FRC1756-Argos/Argos-Battery-Charge-Monitor/README.md

# Argos-Battery-Charge-Monitor
System to monitor a set of charging batteries
