FRC1756-Argos/Argos-Battery-Charge-Monitor/PCB/BOM.xlsx

Sheet: Sensor
Label | Description | Part | Quantity | Unit Price | Total Price | URL
U1 | 20A Current Sensor | ACS712ELCTR-20A-T | 1 | 3.94 | 3.94 | https://www.digikey.com/product-detail/en/allegro-microsystems-llc/ACS712ELCTR-20A-T/620-1190-1-ND/1284607
U2 | 5V Linear Regulator | L78M05CDT-TR | 1 | 0.367 | 0.367 | https://www.digikey.com/product-detail/en/stmicroelectronics/L78M05CDT-TR/497-1203-1-ND/586203
U3 | ATTiny 84 | ATTINY84A-SSU | 1 | 0.82 | 0.82 | https://www.digikey.com/product-detail/en/microchip-technology/ATTINY84A-SSU/ATTINY84A-SSU-ND/3046522
U4 | I2C Differential Driver | PCA9615DPJ | 1 | 2.62 | 2.62 | https://www.digikey.com/product-detail/en/nxp-usa-inc/PCA9615DPJ/568-11484-1-ND/4864508
 | RJ-25 Port | E5566-Q0LK22-L | 2 | 0.3512 | 0.7024 | https://www.digikey.com/product-detail/en/pulse-electronics-network/E5566-Q0LK22-L/553-2258-ND/1785239
 | DIP Switches | 210-4MS | 1 | 0.543 | 0.543 | https://www.digikey.com/product-detail/en/cts-electrocomponents/210-4MS/CT2104MS-ND/2503781
R1 | 30K Resistor (Voltage Divider) | RMCF0805JT30K0 | 1 | 0.017 | 0.017 | https://www.digikey.com/product-detail/en/stackpole-electronics-inc/RMCF0805JT30K0/RMCF0805JT30K0CT-ND/1942584
R2 | 10K Resistor (Voltage Divider) | RMCF0805JT10K0 | 1 | 0.017 | 0.017 | https://www.digikey.com/product-detail/en/stackpole-electronics-inc/RMCF0805JT10K0/RMCF0805JT10K0CT-ND/1942577
R3 | 4.7K Resisor (I2C Pull Up) | RMCF0805JT4K70 | 2 | 0.017 | 0.034 | https://www.digikey.com/product-detail/en/stackpole-electronics-inc/RMCF0805JT4K70/RMCF0805JT4K70CT-ND/1942570
R4 | 600 Resistor (Differential I2C Pull) | RC0805FR-07604RL | 4 | 0.022 | 0.088 | https://www.digikey.com/product-detail/en/yageo/RC0805FR-07604RL/311-604CRCT-ND/731022
R5 | 120 Resistor (Differential I2C Terminator) | RMCF0805JT120R | 2 | 0.017 | 0.034 | https://www.digikey.com/product-detail/en/stackpole-electronics-inc/RMCF0805JT120R/RMCF0805JT120RCT-ND/1942540
R6 | 160 Resistor (LED Limit) | RMCF0805JT160R | 1 | 0.017 | 0.017 | https://www.digikey.com/product-detail/en/stackpole-electronics-inc/RMCF0805JT160R/RMCF0805JT160RCT-ND/5049817
 | ISP Header | PPPC032LFBN-RC | 1 | 0.586 | 0.586 | https://www.digikey.com/product-detail/en/sullins-connector-solutions/PPPC032LFBN-RC/S7106-ND/810243
C1 | Decoupling Capacitor | CL21B104KBFNNNG | 3 | 0.02 | 0.06 | https://www.digikey.com/product-detail/en/samsung-electro-mechanics/CL21B104KBFNNNG/1276-6468-1-ND/5958096
 |  |  | One Board | 9.8454
 |  |  | Num Boards | 10
 |  |  | Total | 98.454

Sheet: HAT
Label | Description | Part | Quantity | Unit Price | Total Price | URL
U1 | I2C Differential Driver | PCA9615DPJ | 1 | 2.62 | 2.62 | https://www.digikey.com/product-detail/en/nxp-usa-inc/PCA9615DPJ/568-11484-1-ND/4864508
 | RJ-25 Port | E5566-Q0LK22-L | 1 | 0.3512 | 0.3512 | https://www.digikey.com/product-detail/en/pulse-electronics-network/E5566-Q0LK22-L/553-2258-ND/1785239
R1 | 600 Resistor (Differential I2C Pull) | RC0805FR-07604RL | 4 | 0.022 | 0.088 | https://www.digikey.com/product-detail/en/yageo/RC0805FR-07604RL/311-604CRCT-ND/731022
R2 | 120 Resistor (Differential I2C Terminator) | RMCF0805JT120R | 2 | 0.017 | 0.034 | https://www.digikey.com/product-detail/en/stackpole-electronics-inc/RMCF0805JT120R/RMCF0805JT120RCT-ND/1942540
 | 2x20 HAT Header | SSQ-120-03-T-D | 1 | 4.5 | 4.5 | https://www.digikey.com/product-detail/en/samtec-inc/SSQ-120-03-T-D/SAM1204-20-ND/1111840
U2 | RTC | DS3231MZ+ | 1 | 7.72 | 7.72 | https://www.digikey.com/product-detail/en/maxim-integrated/DS3231MZ/DS3231MZ-ND/2754396
 | Backup Battery Holder | BAT-HLD-012-THM | 1 | 0.28 | 0.28 | https://www.digikey.com/product-detail/en/linx-technologies-inc/BAT-HLD-012-THM/BAT-HLD-012-THM-ND/3044012
C1 | Decoupling Capacitor | CL21B104KBFNNNG | 3 | 0.02 | 0.06 | https://www.digikey.com/product-detail/en/samsung-electro-mechanics/CL21B104KBFNNNG/1276-6468-1-ND/5958096
 |  |  | One Board | 15.6532
 |  |  | Num Boards | 1
 |  |  | Total | 15.6532
