FRC1756-Argos/Argos-Battery-Charge-Monitor/PCB/HAT/Argos_Battery_Charge_Monitor_HAT.brd

## EAGLE design PCB/HAT/Argos_Battery_Charge_Monitor_HAT.brd (2017-11-20)

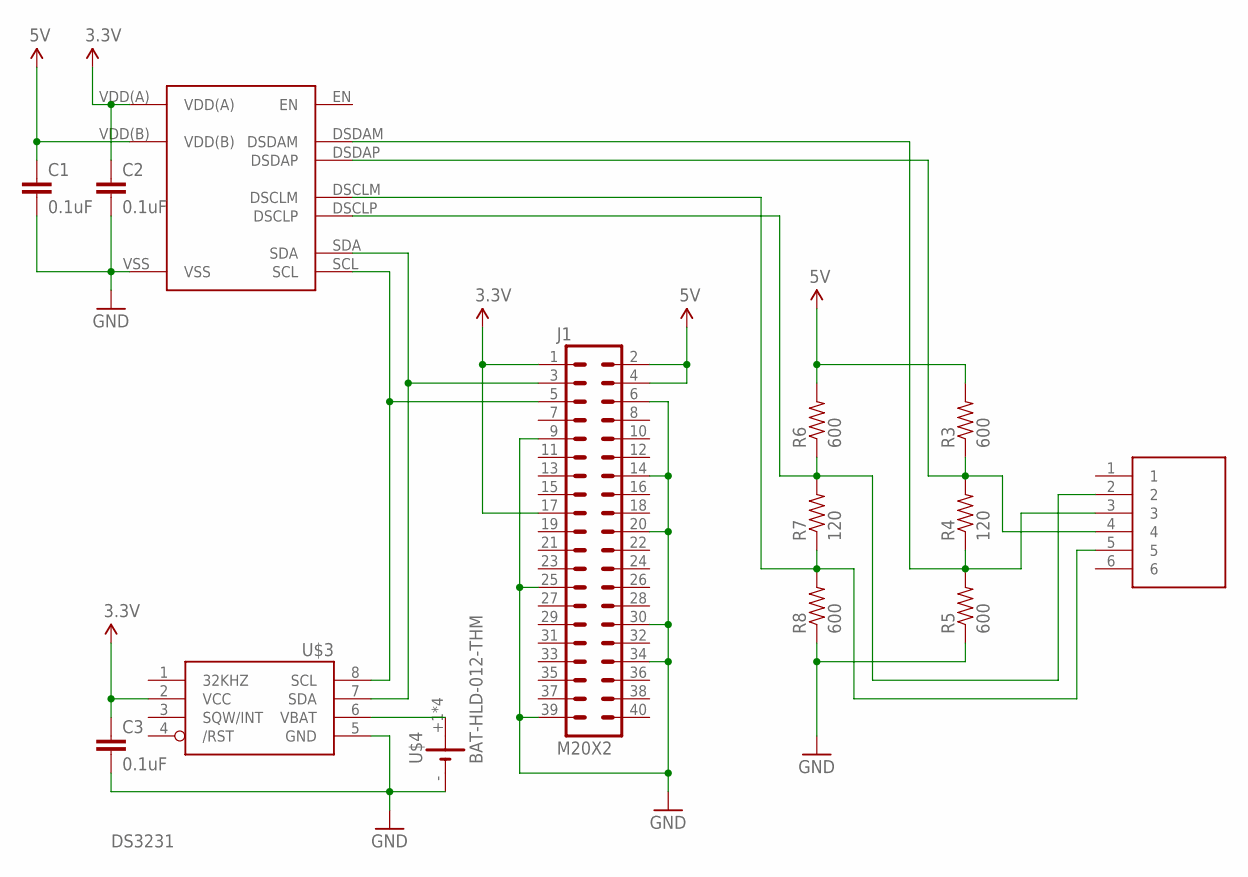
[picture p1: schematic Argos_Battery_Charge_Monitor_HAT.sch]

Parts:
C1, C2, C3: 0.1uF; 0805
J1: M20X2; 2X20
R3, R5, R6, R8: 600; 0805
R4, R7: 120; 0805
U$1: E5566-Q0LK22-L
U$2: SOP50P490X110-10N
U$3: DS3231MZ; SOIC8
U$4: BAT-HLD-012-THM

Connections:
3.3V: C2.1, C3.1, J1.1, J1.17, U$2.VDD(A), U$3.2 (VCC)
5V: C1.1, J1.2, J1.4, R3.2, R6.2, U$2.VDD(B)
D_SCL_M: R7.1, R8.2, U$1.5, U$2.DSCLM
D_SCL_P: R6.1, R7.2, U$1.2, U$2.DSCLP
D_SDA_M: R4.1, R5.2, U$1.3, U$2.DSDAM
D_SDA_P: R3.1, R4.2, U$1.4, U$2.DSDAP
GND: C1.2, C2.2, C3.2, J1.6, J1.9, J1.14, J1.20, J1.25, J1.30, J1.34, J1.39, R5.1, R8.1, U$2.VSS, U$3.5 (GND), U$4.-
unnamed: U$3.6 (VBAT), U$4.+1 (+), U$4.+2 (+), U$4.+3 (+), U$4.+4 (+)
SCL: J1.5, U$2.SCL, U$3.8 (SCL)
SDA: J1.3, U$2.SDA, U$3.7 (SDA)

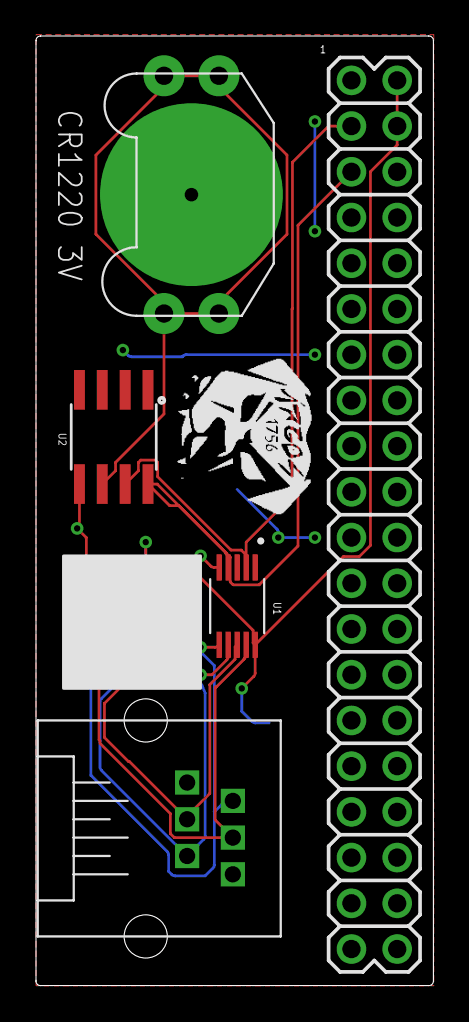
[picture p2: board Argos_Battery_Charge_Monitor_HAT.brd from above]

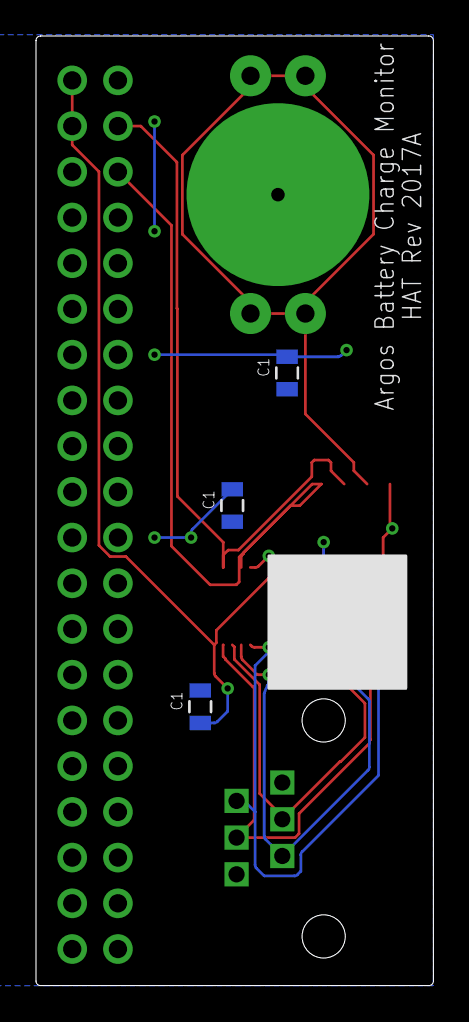
[picture p3: board Argos_Battery_Charge_Monitor_HAT.brd from below]

Board: 2 copper layers, 22.1 x 52.8 mm, 14 parts (6 on the bottom side), 10 nets.
