FRC1756-Argos/Argos-Battery-Charge-Monitor/PCB/Sensor/Argos_Battery_Charge_Monitor_Sensor.brd

## EAGLE design PCB/Sensor/Argos_Battery_Charge_Monitor_Sensor.brd (2017-11-20)

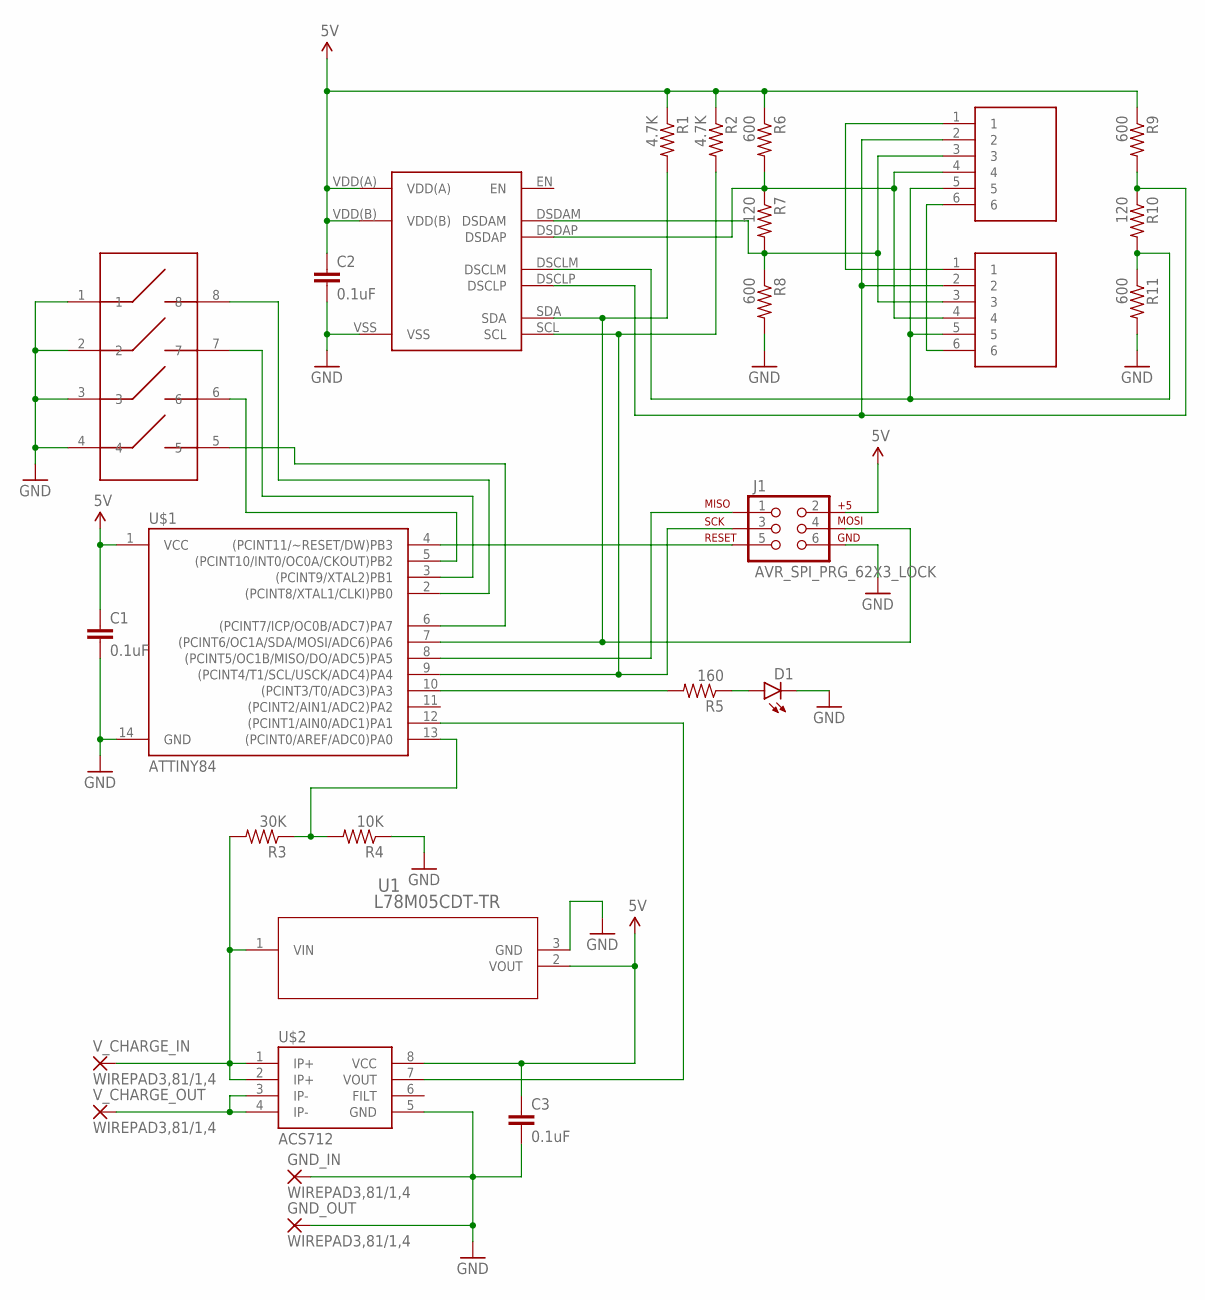
[picture p4: schematic Argos_Battery_Charge_Monitor_Sensor.sch]

Parts:
C1, C2, C3: 0.1uF; 0805
D1: LED3MM
GND_IN: WIREPAD3,81/1,4; 3,81/1,4
GND_OUT: WIREPAD3,81/1,4; 3,81/1,4
J1: AVR_SPI_PRG_62X3_LOCK; 2X3_LOCK
R1, R2: 4.7K; 0805
R3: 30K; 0805
R4: 10K; 0805
R5: 160; 0805
R6, R8, R9, R11: 600; 0805
R7, R10: 120; 0805
U1: L78M05CDT-TR; DPAK
U$1: ATTINY84; SO14
U$2: ACS712; SO08
U$3: SOP50P490X110-10N
U$4, U$5: E5566-Q0LK22-L
U$6: 210-4MS
V_CHARGE_IN: WIREPAD3,81/1,4; 3,81/1,4
V_CHARGE_OUT: WIREPAD3,81/1,4; 3,81/1,4

Connections:
5V: C1.1, C2.1, C3.1, J1.2, R1.1, R2.1, R6.1, R9.1, U1.2 (VOUT), U$1.1 (VCC), U$2.8 (VCC), U$3.VDD(A), U$3.VDD(B)
D_SCK_M: R10.2, R11.1, U$3.DSCLM, U$4.5, U$5.5
D_SCK_P: R9.2, R10.1, U$3.DSCLP, U$4.2, U$5.2
D_SDA_M: R7.2, R8.1, U$3.DSDAM, U$4.3, U$5.3
D_SDA_P: R6.2, R7.1, U$3.DSDAP, U$4.4, U$5.4
GND: C1.2, C2.2, C3.2, D1.K (C), GND_IN.1, GND_OUT.1, J1.6, R4.1, R8.2, R11.2, U1.3 (GND), U$1.14 (GND), U$2.5 (GND), U$3.VSS, U$6.1, U$6.2, U$6.3, U$6.4
unnamed: U$4.1, U$5.1
unnamed: U$1.5 ((PCINT10/INT0/OC0A/CKOUT)PB2), U$6.6
unnamed: U$1.3 ((PCINT9/XTAL2)PB1), U$6.7
unnamed: U$1.2 ((PCINT8/XTAL1/CLKI)PB0), U$6.8
unnamed: U$1.6 ((PCINT7/ICP/OC0B/ADC7)PA7), U$6.5
unnamed: U$4.6, U$5.6
unnamed: R3.2, U1.1 (VIN), U$2.1 (IP+), U$2.2 (IP+), V_CHARGE_IN.1
unnamed: R3.1, R4.2, U$1.13 ((PCINT0/AREF/ADC0)PA0)
unnamed: U$2.3 (IP-), U$2.4 (IP-), V_CHARGE_OUT.1
unnamed: U$1.12 ((PCINT1/AIN0/ADC1)PA1), U$2.7 (VOUT)
unnamed: D1.A, R5.1
unnamed: J1.5, U$1.4 ((PCINT11/~RESET/DW)PB3)
unnamed: J1.1, U$1.8 ((PCINT5/OC1B/MISO/DO/ADC5)PA5)
unnamed: R5.2, U$1.10 ((PCINT3/T0/ADC3)PA3)
SCL: J1.3, R2.2, U$1.9 ((PCINT4/T1/SCL/USCK/ADC4)PA4), U$3.SCL
SDA: J1.4, R1.2, U$1.7 ((PCINT6/OC1A/SDA/MOSI/ADC6)PA6), U$3.SDA

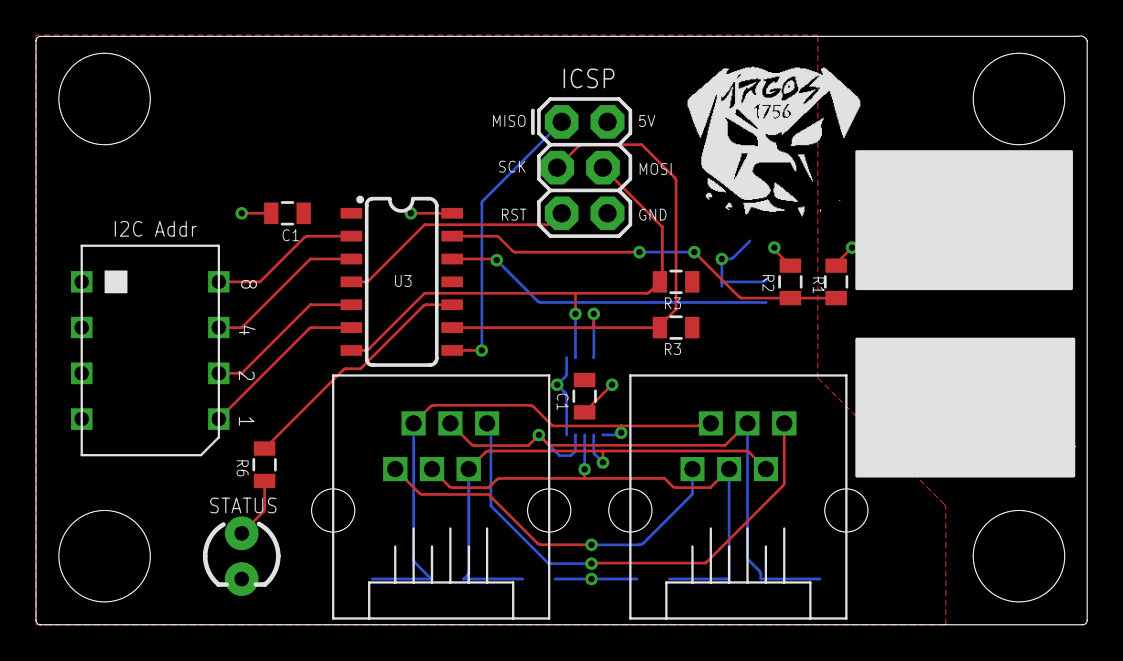
[picture p5: board Argos_Battery_Charge_Monitor_Sensor.brd from above]

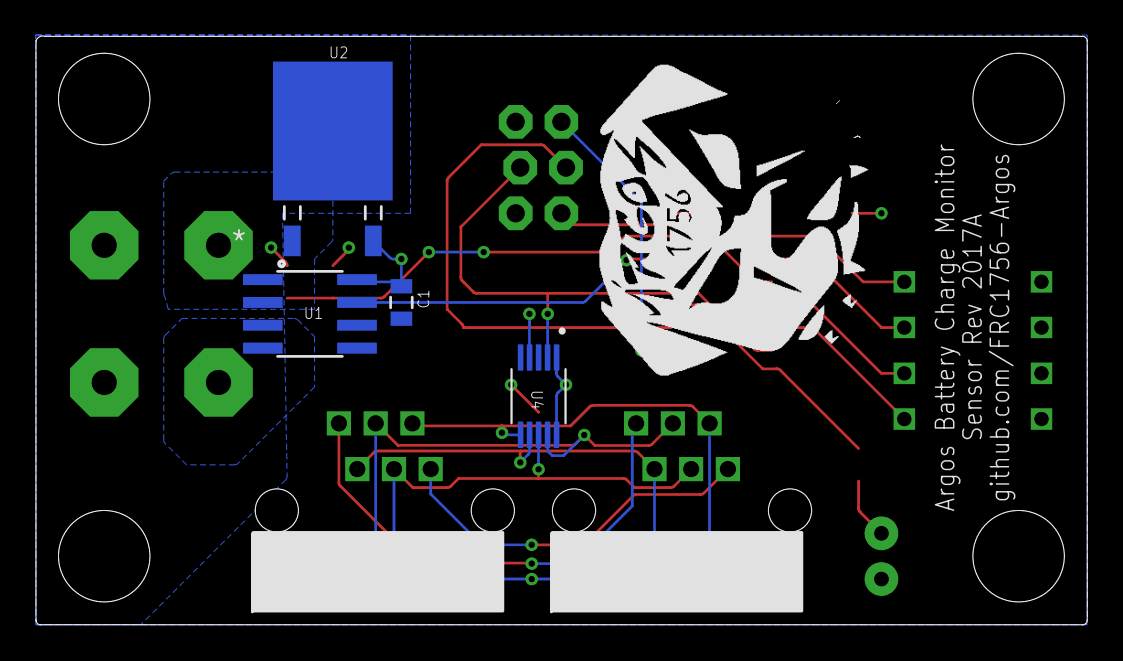
[picture p6: board Argos_Battery_Charge_Monitor_Sensor.brd from below]

Board: 2 copper layers, 58.4 x 32.7 mm, 27 parts (10 on the bottom side), 22 nets.
