FRC1756-Argos/Argos-Battery-Charge-Monitor/(commit log)

2017-11-18 Identified sensor components and finished sensor schematic
    [Argos_Battery_Charge_Monitor_Sensor.brd, Argos_Battery_Charge_Monitor_Sensor.sch, BOM.xlsx]
2017-11-20 2017 RevA boards complete
    [Argos_Battery_Charge_Monitor_HAT.brd, Argos_Battery_Charge_Monitor_HAT.sch, Argos_Battery_Charge_Monitor_Sensor.brd, Argos_Battery_Charge_Monitor_Sensor.sch, BOM.xlsx]
2017-11-20 Fixed quantity on a couple components
    [BOM.xlsx]
2017-12-12 Initial version with working I2C communications and voltage measurement. Current measurement seems good, too, but I haven't tested it thoroughly
